elegantalchemist/dekatron-speed/images/readme.md

# Images of the project

You know what they say, all that text is useless without showing you what goes on. Here's some pictures.

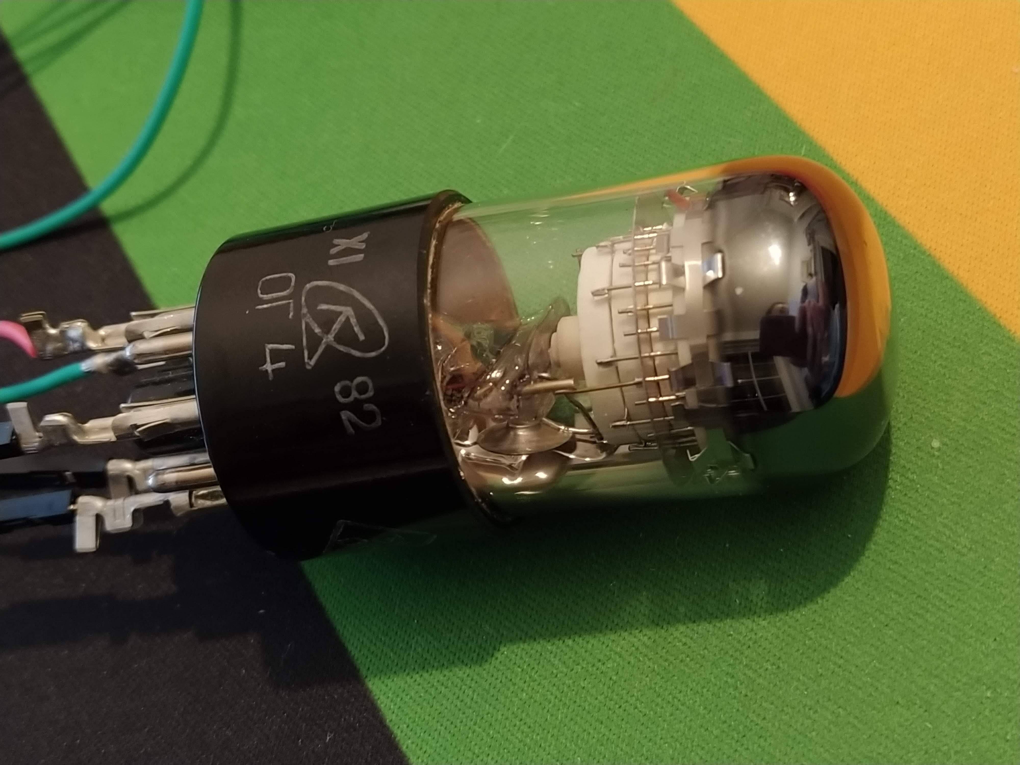
[picture p1: images/1 - A Dekatron.jpg]
A Dekatron


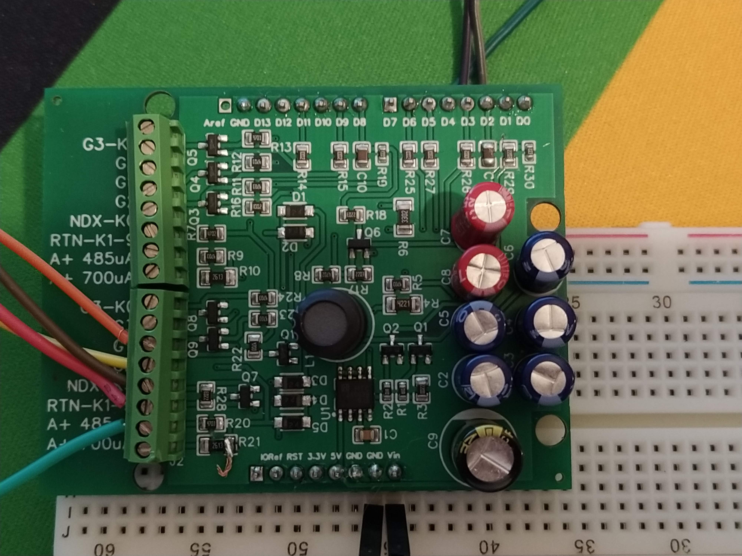
[picture p2: images/2 - Arduino shield fabricated.jpg]
Arduino shield fabricated


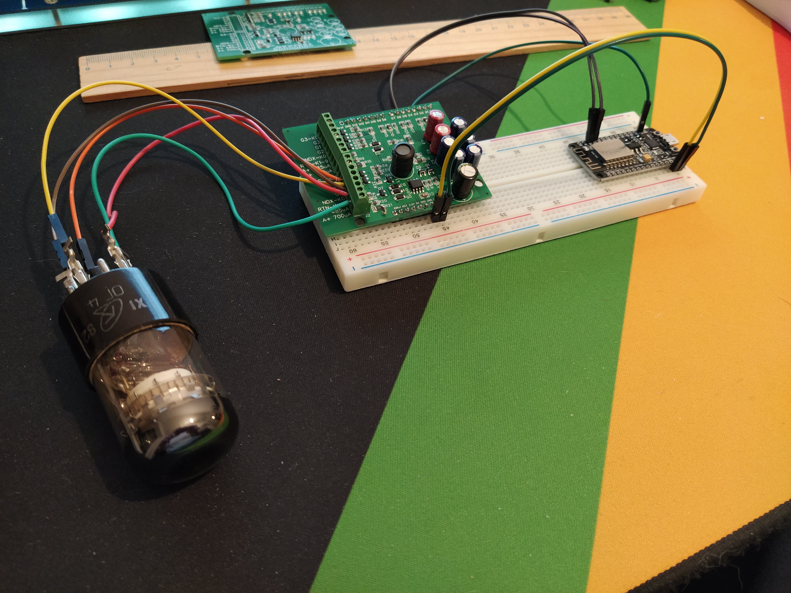
[picture p3: images/3 - Breadboarding.jpg]
Breadboarding


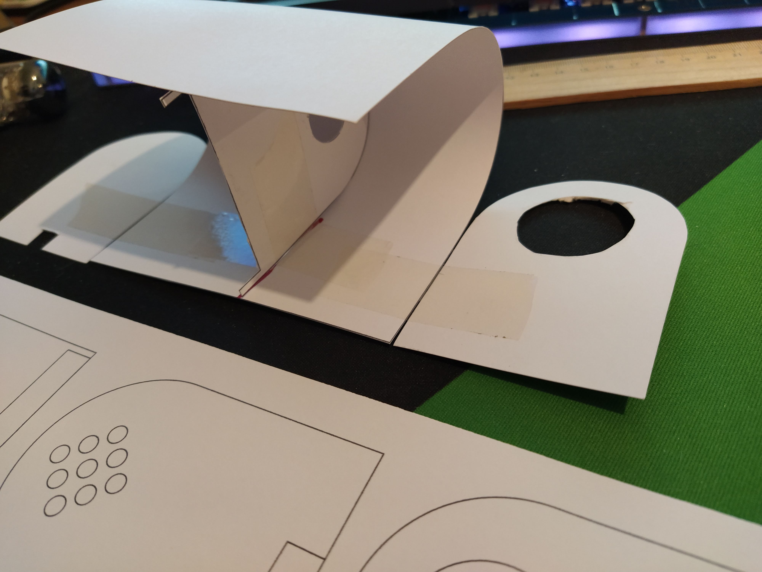
[picture p4: images/4 - Case trial.jpg]
Case Trial


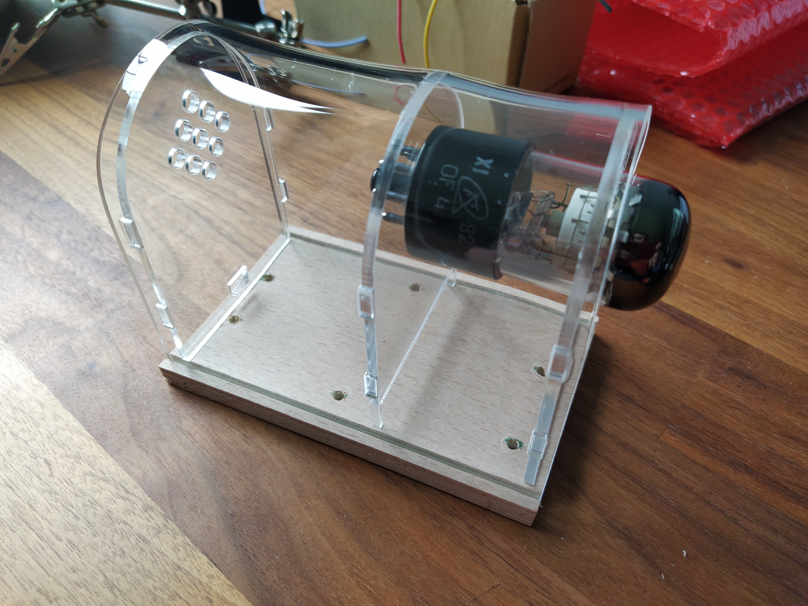
[picture p5: images/5 - Acrylic Case Assembled.jpg]
Case Assembled


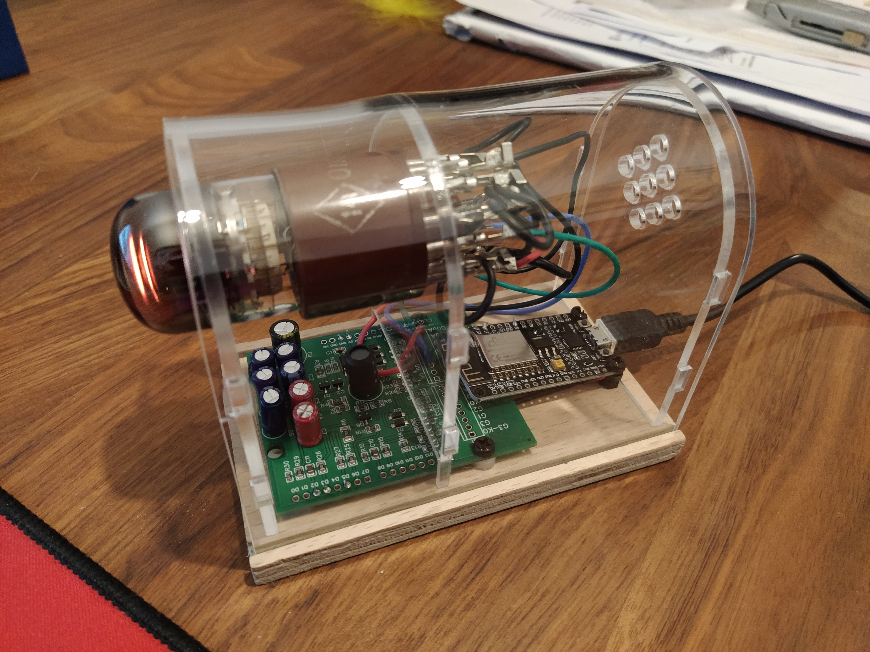
[picture p6: images/6 - Finished.jpg]
Finished


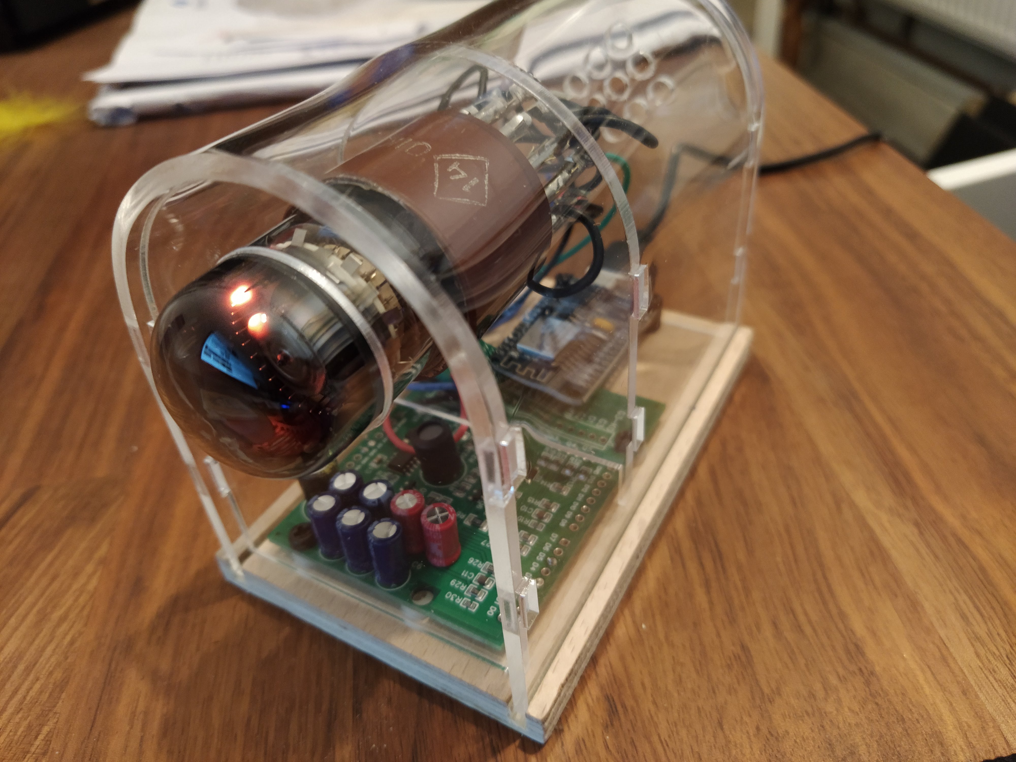
[picture p7: images/7 - Finished.jpg]
Finished
