elegantalchemist/dekatron-speed/case/Acrylic Case.pdf

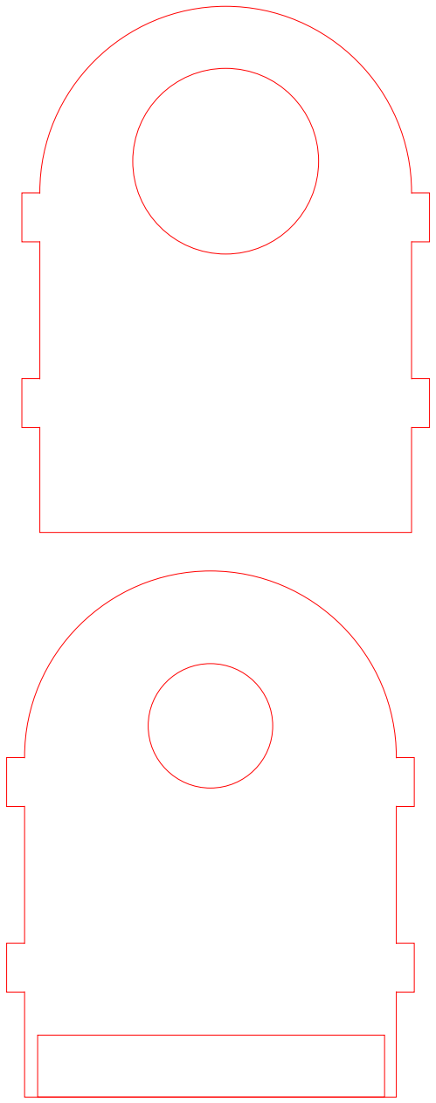
[picture p8: figure]
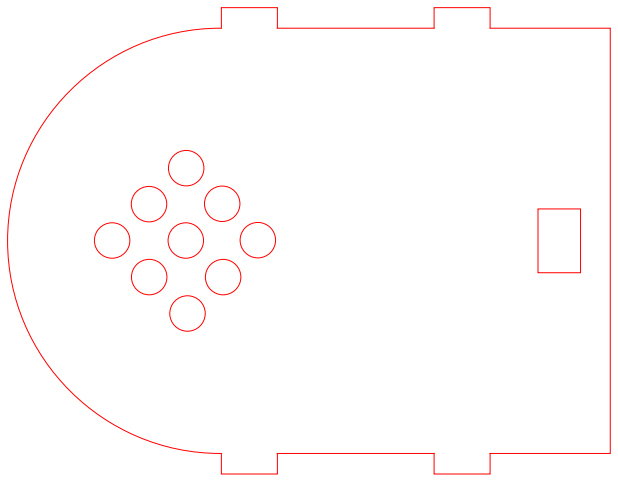
[picture p9: figure]
