elegantalchemist/dekatron-speed/hardware/3D View.PNG

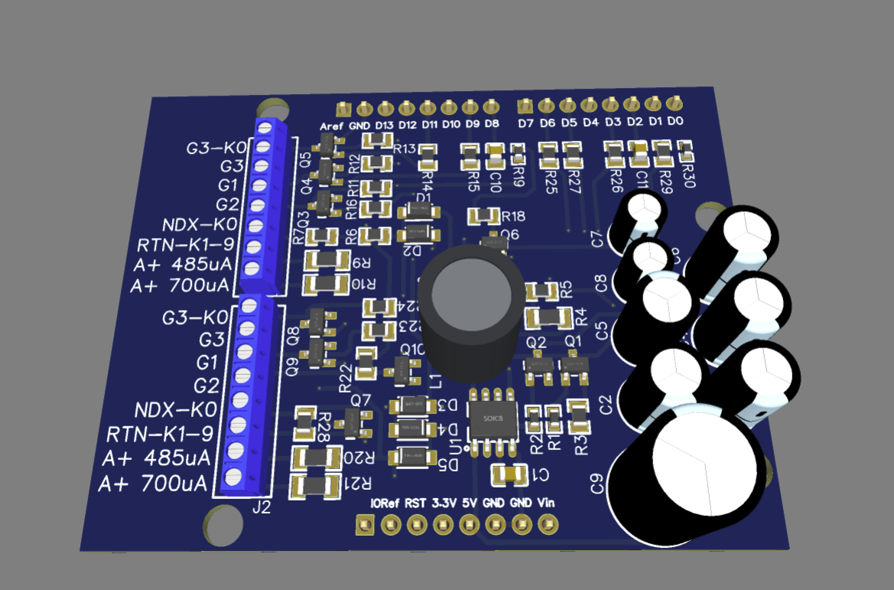
hardware/3D View.PNG
