elegantalchemist/dekatron-speed/hardware/Schematic_Updated.pdf

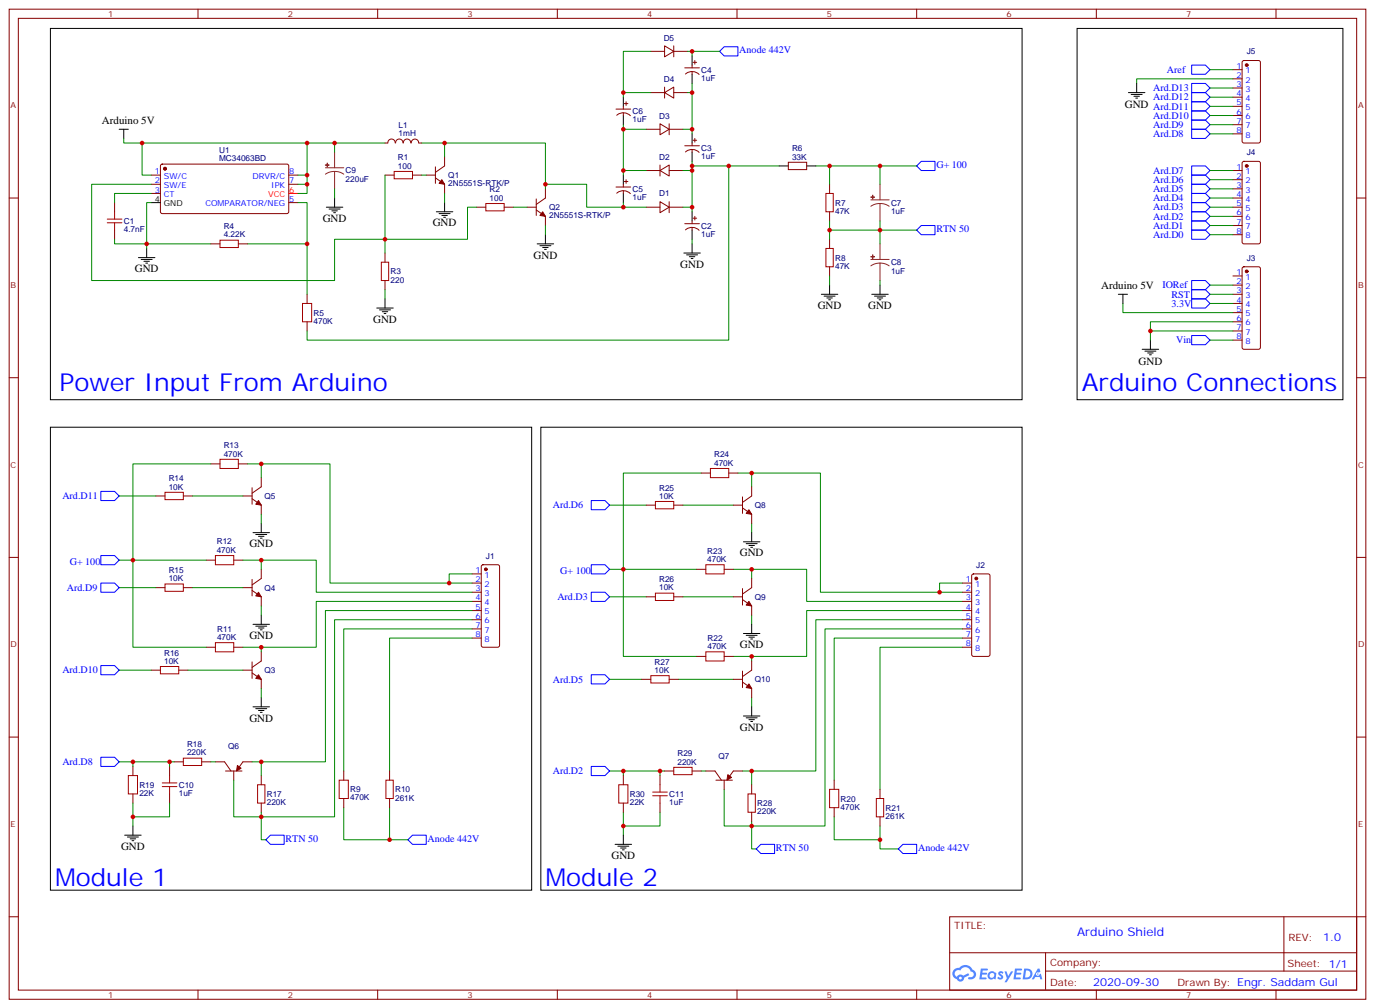
[picture p11: page 1]

Drawn By: Engr. Saddam Gul
