elegantalchemist/dekatron-speed/hardware/5b - Board assembly schematic.jpg

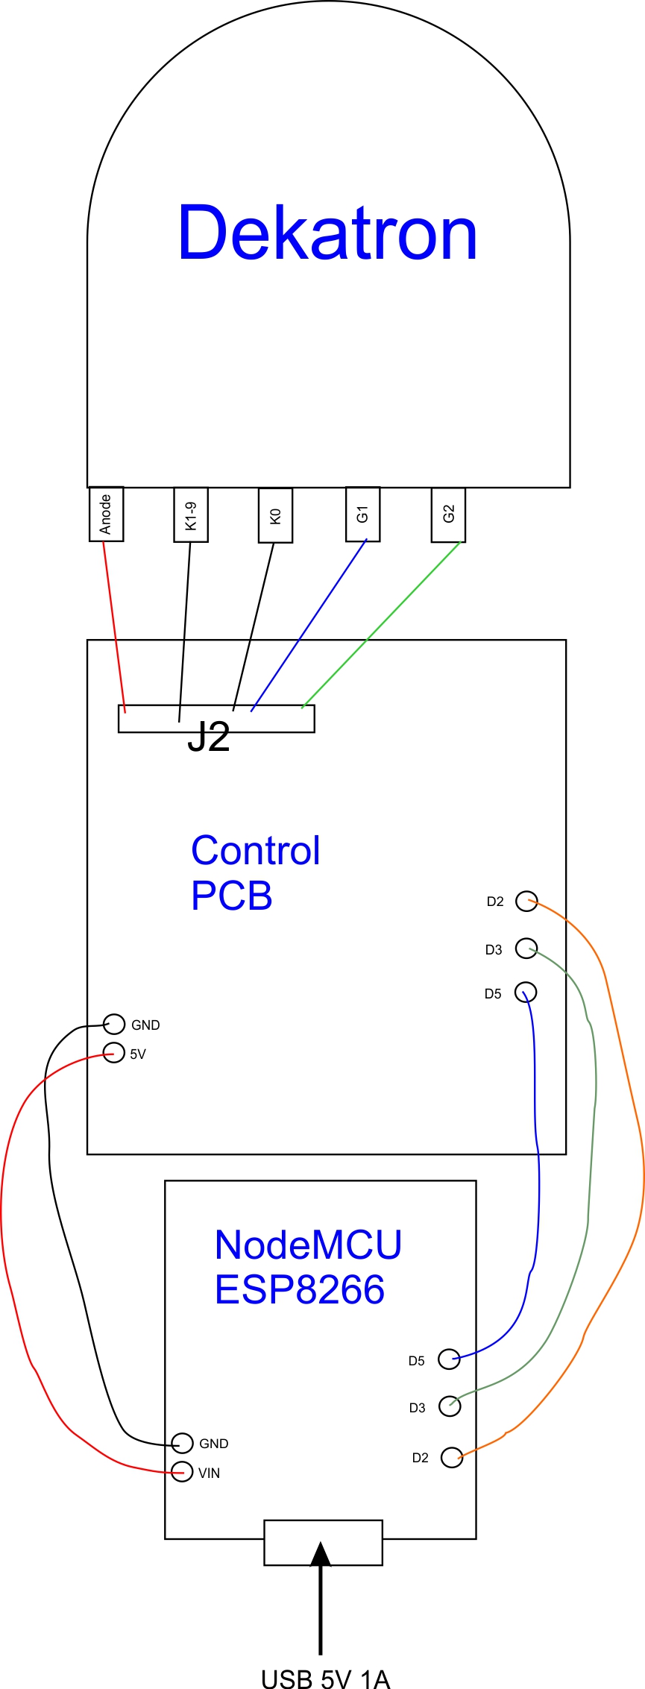
hardware/5b - Board assembly schematic.jpg
