elegantalchemist/dekatron-speed/(commit log)

2020-11-16 Create spinner.ino
    A simple spinner - control spin rate and direction on a double pulse Dekatron using an Arduino
2020-11-16 Create spinner-regenerator.ino
    A simple sketch to spin at a set speed and reverse direction every 20 seconds. Helpful for testing and running dekatrons which are a bit sticky.
    [spinner-regenerator.ino]
2020-11-16 Create 3-guide-variation
    how to drive a 3-guide single pulse dekatron using an arduino
2020-11-16 Add files via upload
    Coreldraw X16 file type (CDR is common and popular with laser cutters)
